gnery7/Bracorobotico/README.md

# Bracorobotico
Projeto do Braço robotico articulado com 6 Servos MG996R

Nosso objetivo nesse projeto é a construção e desenvolvimento de um braço articulado utilizando impressão 3D, utilizando a placa Arduino UNO com o microcontrolador ATMEGA 238P, e utilizando motores do tipo “servo”, os modelos MG995R e SG90 serão utilizados para automatização do braço.
